lewispg228/Serial_LCD_testbeds/README.md

# Serial_LCD_testbeds
This repo will house testbeds for the new Serial LCDs (both versions: 16x2, 20x4)
