lewispg228/Serial_LCD_testbeds/16x2/TB EAGLE/For lazering/SerLCD_16x2_WT-v01.dxf

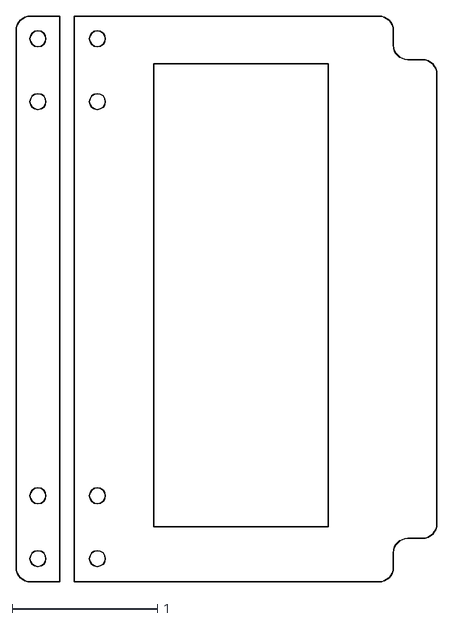
[picture p2: CAD file, 2018-10-10]
16x2/TB EAGLE/For lazering/SerLCD_16x2_WT-v01.dxf
2.90 x 3.90
