lewispg228/Serial_LCD_testbeds/16x2/TB EAGLE/For lazering/SerLCD_16x2_PM-v01.dxf

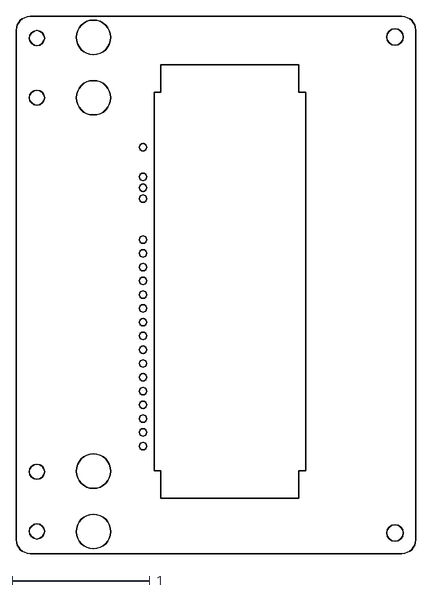
[picture p3: CAD file, 2018-06-07]
16x2/TB EAGLE/For lazering/SerLCD_16x2_PM-v01.dxf
2.90 x 3.90
