lewispg228/Serial_LCD_testbeds/20x4/TB EAGLE/PB/SerLCD_20x4_pb.brd

## EAGLE design 20x4/TB EAGLE/PB/SerLCD_20x4_pb.brd (2020-04-27)

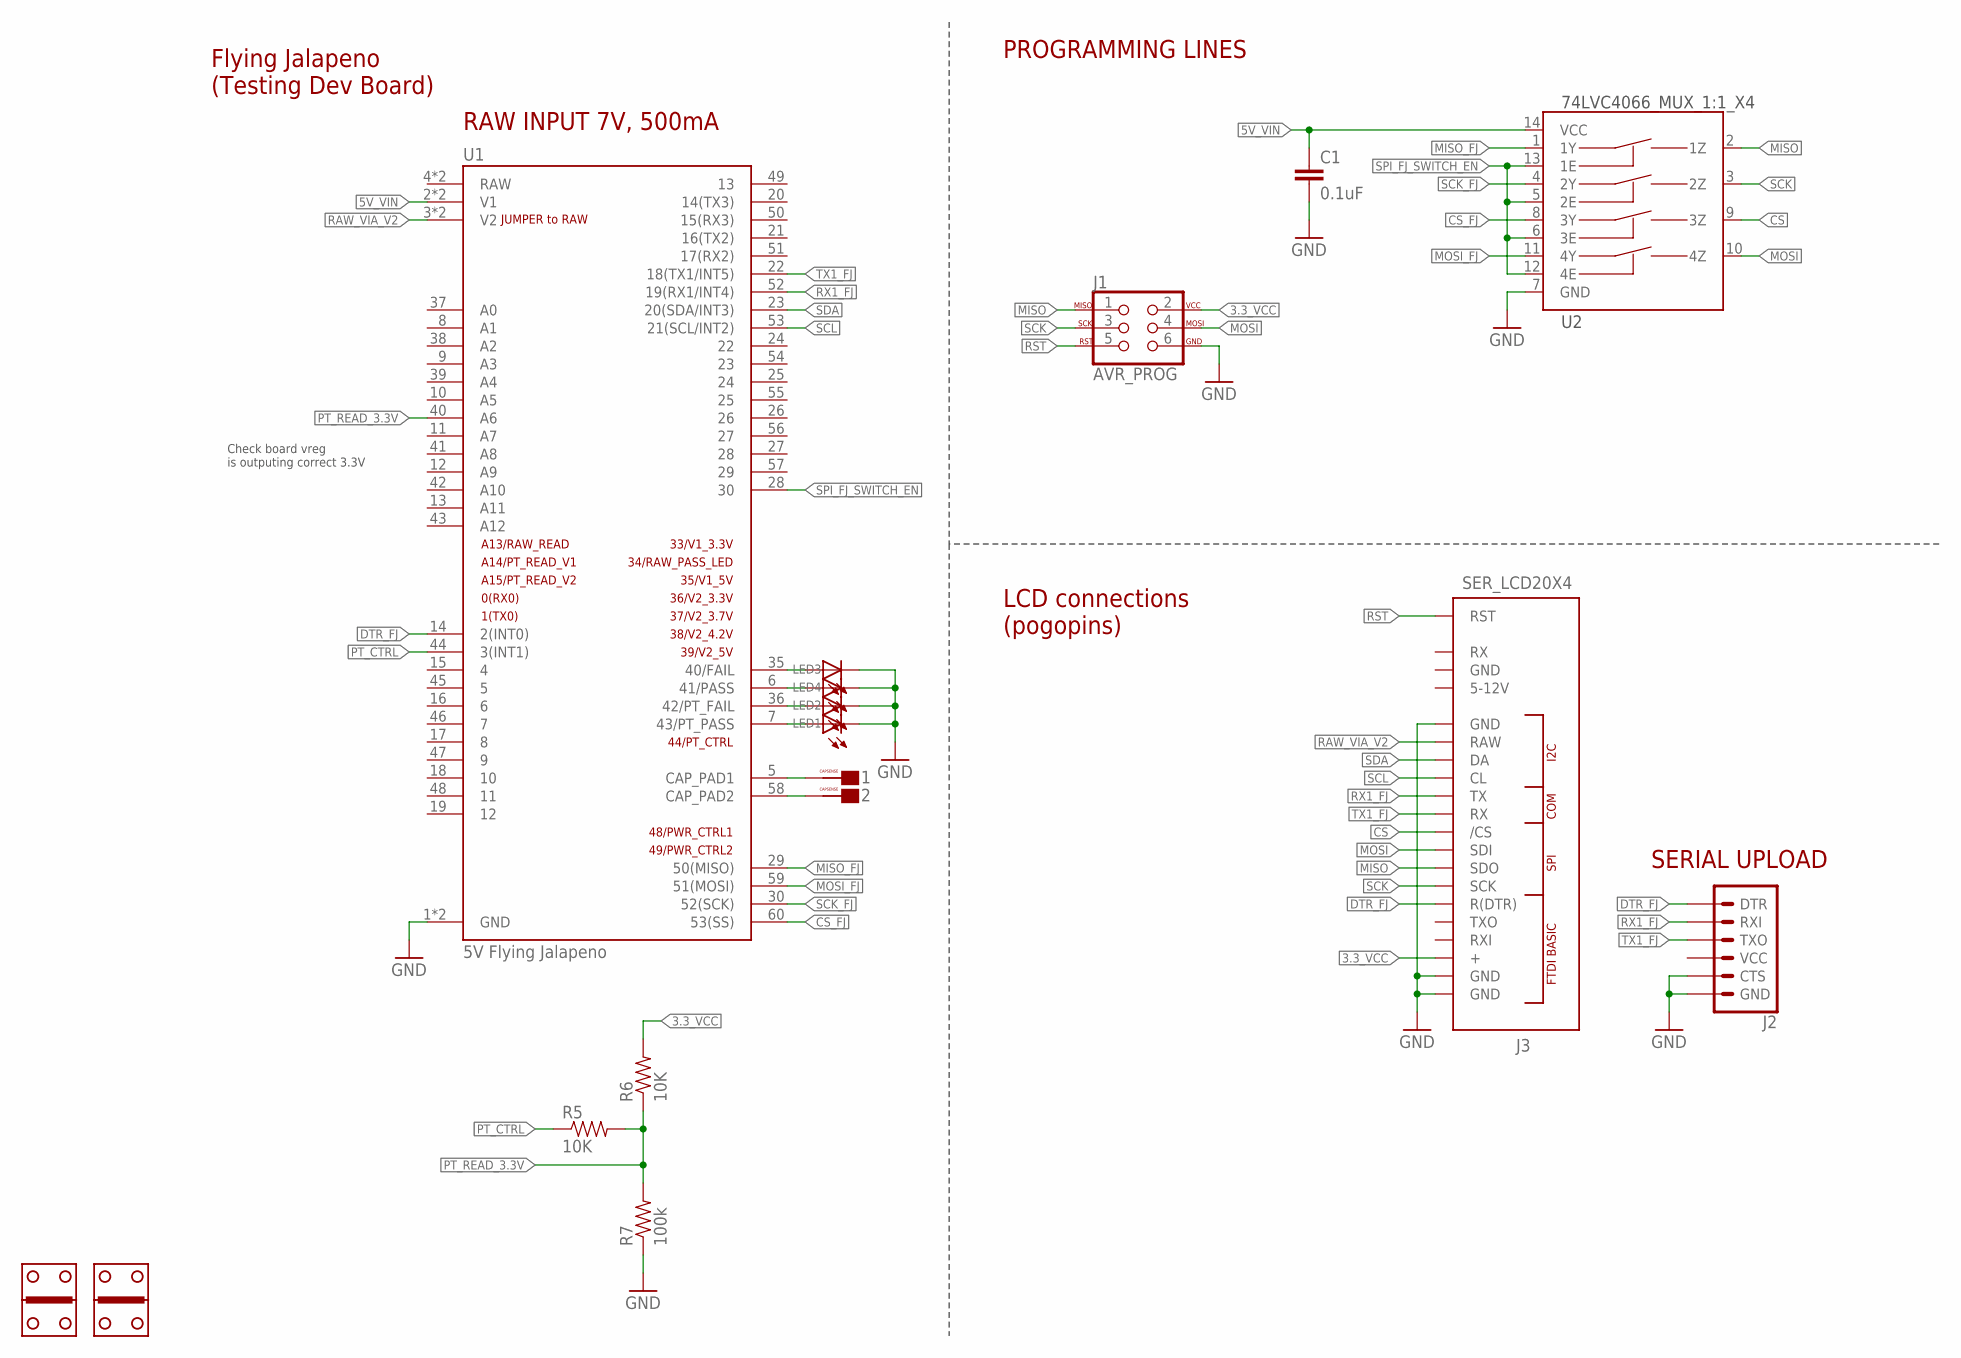
[picture p4: schematic SerLCD_20x4_pb.sch]

Parts:
1, 2: CAPSENSE_BUTTON_PAD_ONLY; CAPSENSE_BUTTON_PADS_ONLY
C1: 0.1uF; 0603-CAP
J1: AVR_PROG; 2X3_LOCK
J2: 6_PIN_SERIAL_TARGETLOCK; 1X06_LOCK
J3: SER_LCD20X4; SER_LCD_20X4
LED1, LED2, LED3, LED4: LED1206; LED-1206
R5, R6: 10K; 0603-RES
R7: 100k; 0603-RES
U1: 5V Flying Jalapeno; FLYING_JALAPENO_V3_1_M
U2: 74LVC4066_MUX_1:1_X4; SO14
U$6, U$7: GOLD_HINDGEPB; GOLD_HINDGE

Connections:
3.3_VCC: J1.2, J3.P$3 (+), R6.2
5V_VIN: C1.1, U1.2 (V1), U1.32 (V1), U2.14 (VCC)
CS: J3.P$10 (/CS), U2.9 (3Z)
CS_FJ: U1.60 (53(SS)), U2.8 (3Y)
DTR_FJ: J2.1 (DTR), J3.P$6 (R(DTR)), U1.14 (2(INT0))
GND: C1.2, J1.6, J2.5 (CTS), J2.6 (GND), J3.P$1 (GND), J3.P$2 (GND), J3.P$16 (GND), LED1.C, LED2.C, LED3.C, LED4.C, R7.1, U1.1 (GND), U1.31 (GND), U2.7 (GND)
MISO: J1.1, J3.P$8 (SDO), U2.2 (1Z)
MISO_FJ: U1.29 (50(MISO)), U2.1 (1Y)
MOSI: J1.4, J3.P$9 (SDI), U2.10 (4Z)
MOSI_FJ: U1.59 (51(MOSI)), U2.11 (4Y)
unnamed: 1.CAPSENSE_PAD, U1.5 (CAP_PAD1)
unnamed: 2.CAPSENSE_PAD, U1.58 (CAP_PAD2)
unnamed: LED1.A, U1.7 (43/PT_PASS)
unnamed: LED2.A, U1.36 (42/PT_FAIL)
unnamed: LED3.A, U1.35 (40/FAIL)
unnamed: LED4.A, U1.6 (41/PASS)
PT_CTRL: R5.1, U1.44 (3(INT1))
PT_READ_3.3V: R5.2, R6.1, R7.2, U1.40 (A6)
RAW_VIA_V2: J3.P$15 (RAW), U1.3 (V2), U1.33 (V2)
RST: J1.5, J3.P$20 (RST)
RX1_FJ: J2.2 (RXI), J3.P$12 (TX), U1.52 (19(RX1/INT4))
SCK: J1.3, J3.P$7 (SCK), U2.3 (2Z)
SCK_FJ: U1.30 (52(SCK)), U2.4 (2Y)
SCL: J3.P$13 (CL), U1.53 (21(SCL/INT2))
SDA: J3.P$14 (DA), U1.23 (20(SDA/INT3))
SPI_FJ_SWITCH_EN: U1.28 (30), U2.5 (2E), U2.6 (3E), U2.12 (4E), U2.13 (1E)
TX1_FJ: J2.3 (TXO), J3.P$11 (RX), U1.22 (18(TX1/INT5))

Notes on the sheet:
Check board vreg is outputing correct 3.3V
JUMPER to RAW
RAW INPUT 7V, 500mA
PROGRAMMING LINES
Flying Jalapeno (Testing Dev Board)
LCD connections (pogopins)
SERIAL UPLOAD

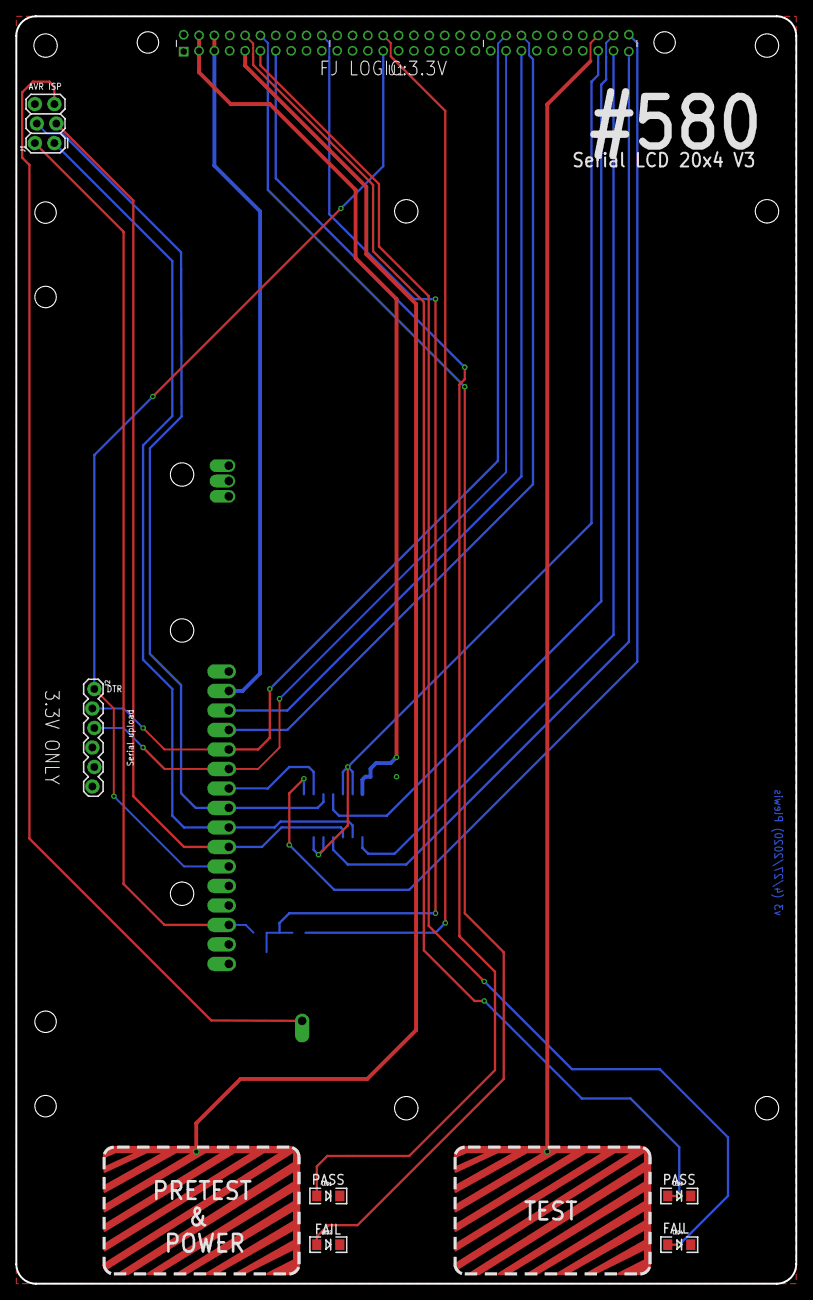
[picture p5: board SerLCD_20x4_pb.brd from above]

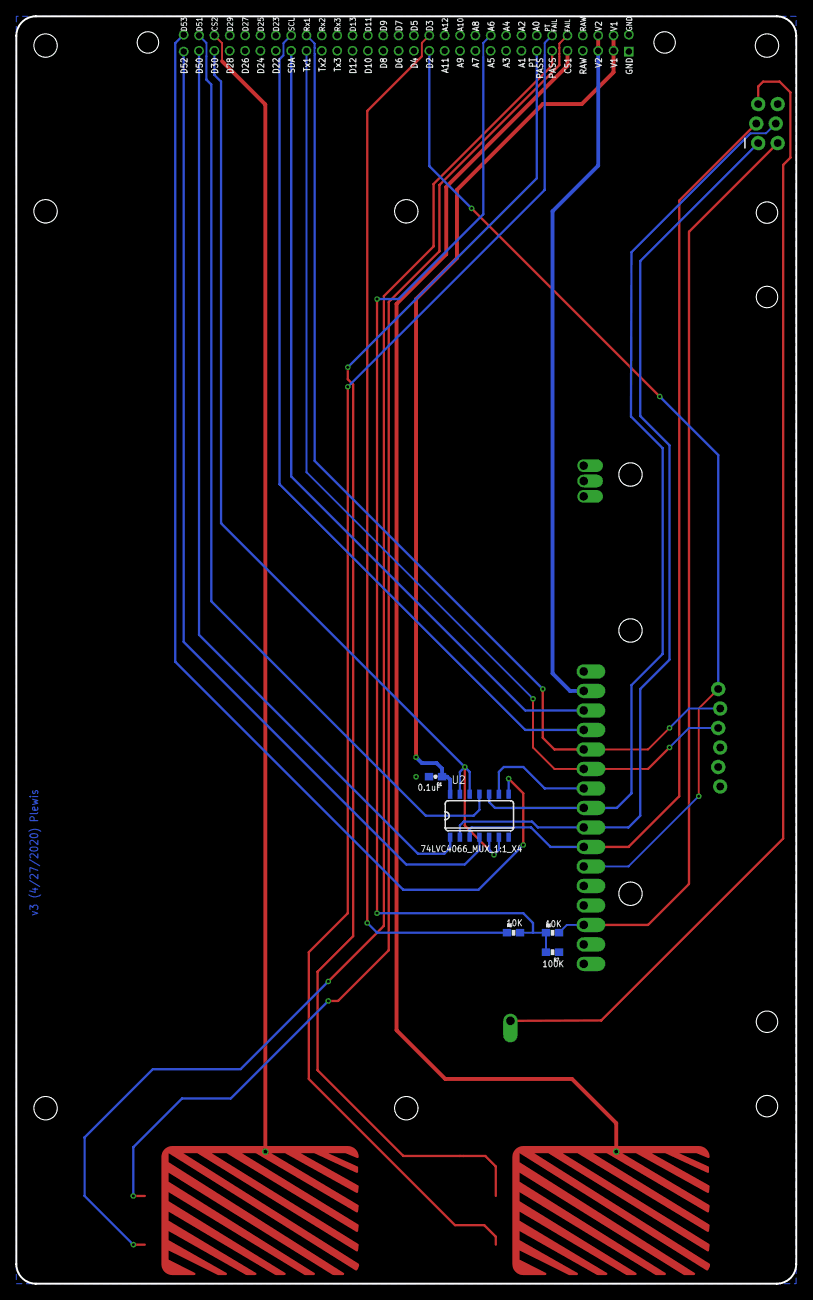
[picture p6: board SerLCD_20x4_pb.brd from below]

Board: 2 copper layers, 101.6 x 165.1 mm, 26 parts (5 on the bottom side), 27 nets.

Other parts of the board:
U$1, U$2, U$3, U$4, U$5, U$8, U$9, U$10, U$11: STAND-OFF-TIGHT
