lewispg228/Serial_LCD_testbeds/16x2/FRITZING_PART/SerLCD_16x2_FRITZTING.brd

## EAGLE design 16x2/FRITZING_PART/SerLCD_16x2_FRITZTING.brd (2018-06-19)

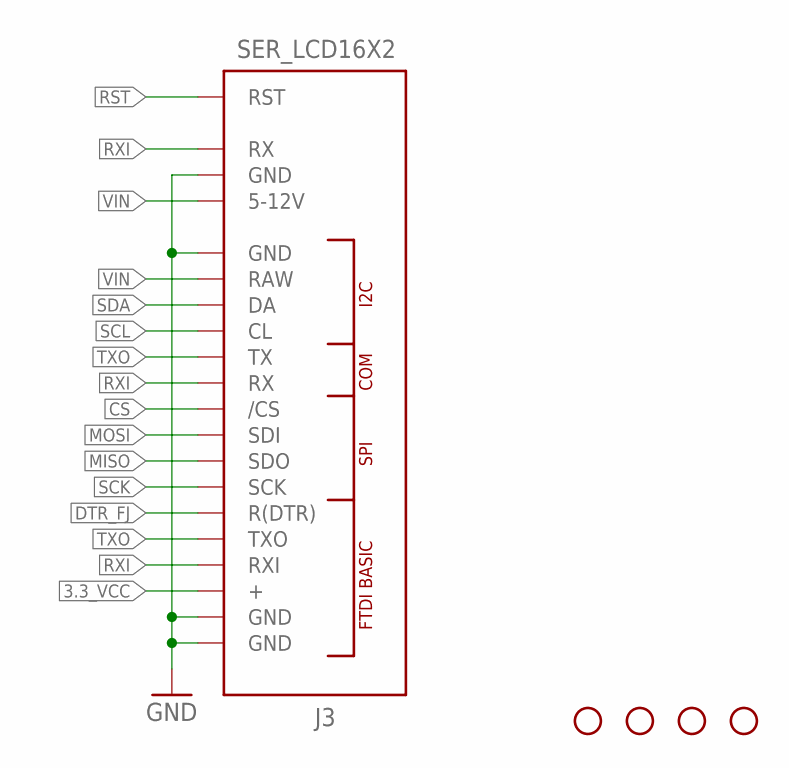
[picture p7: schematic SerLCD_16x2_FRITZTING.sch]

Parts:
H1, H2, H3, H4: STAND-OFF
J3: SER_LCD16X2; SER_LCD_16X2

Connections:
3.3_VCC: J3.P$3 (+)
CS: J3.P$10 (/CS)
DTR_FJ: J3.P$6 (R(DTR))
GND: J3.P$1 (GND), J3.P$2 (GND), J3.P$16 (GND), J3.P$18 (GND)
MISO: J3.P$8 (SDO)
MOSI: J3.P$9 (SDI)
RST: J3.P$20 (RST)
RXI: J3.P$4 (RXI), J3.P$11 (RX), J3.P$19 (RX)
SCK: J3.P$7 (SCK)
SCL: J3.P$13 (CL)
SDA: J3.P$14 (DA)
TXO: J3.P$5 (TXO), J3.P$12 (TX)
VIN: J3.P$15 (RAW), J3.P$17 (5-12V)

Board: 2 copper layers, 5 parts (0 on the bottom side), 4 nets, no tracks yet.
