lewispg228/Serial_LCD_testbeds/16x2/TB EAGLE/PB/SerLCD_16x4_pb-v01.brd

## EAGLE design 16x2/TB EAGLE/PB/SerLCD_16x4_pb-v01.brd (2016-11-15)

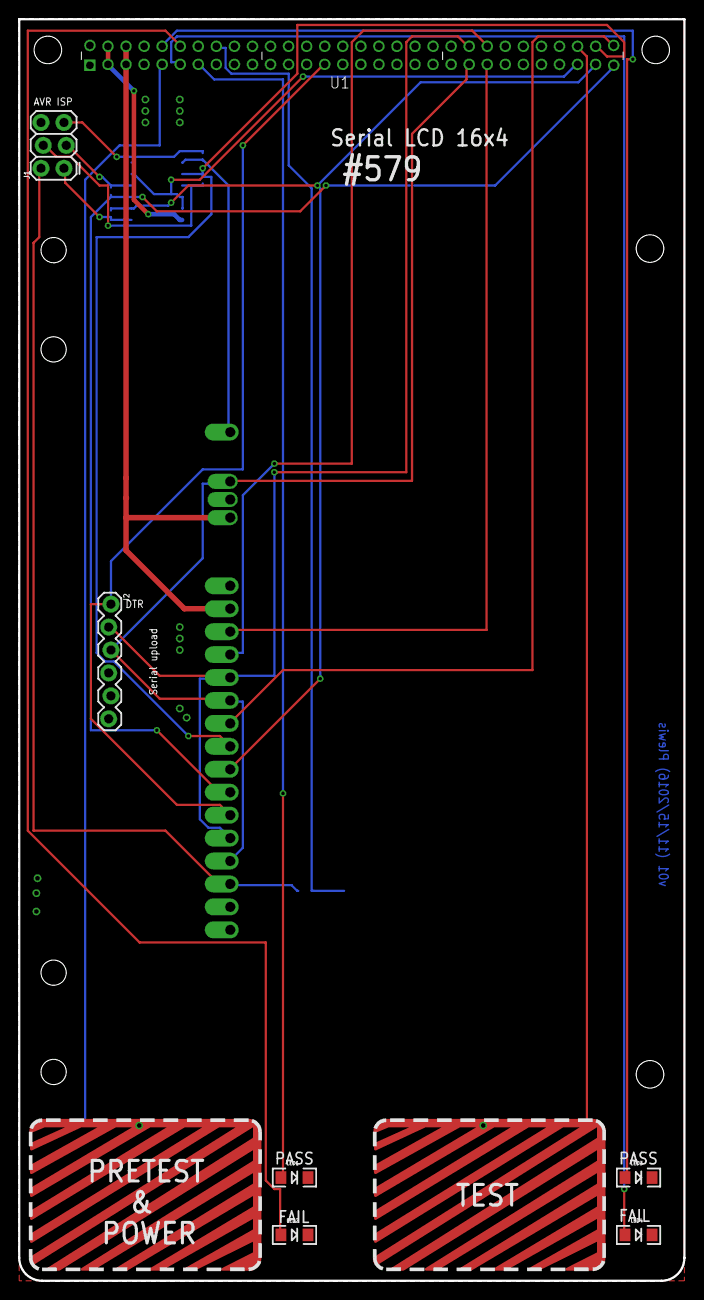
[picture p8: board SerLCD_16x4_pb-v01.brd from above]

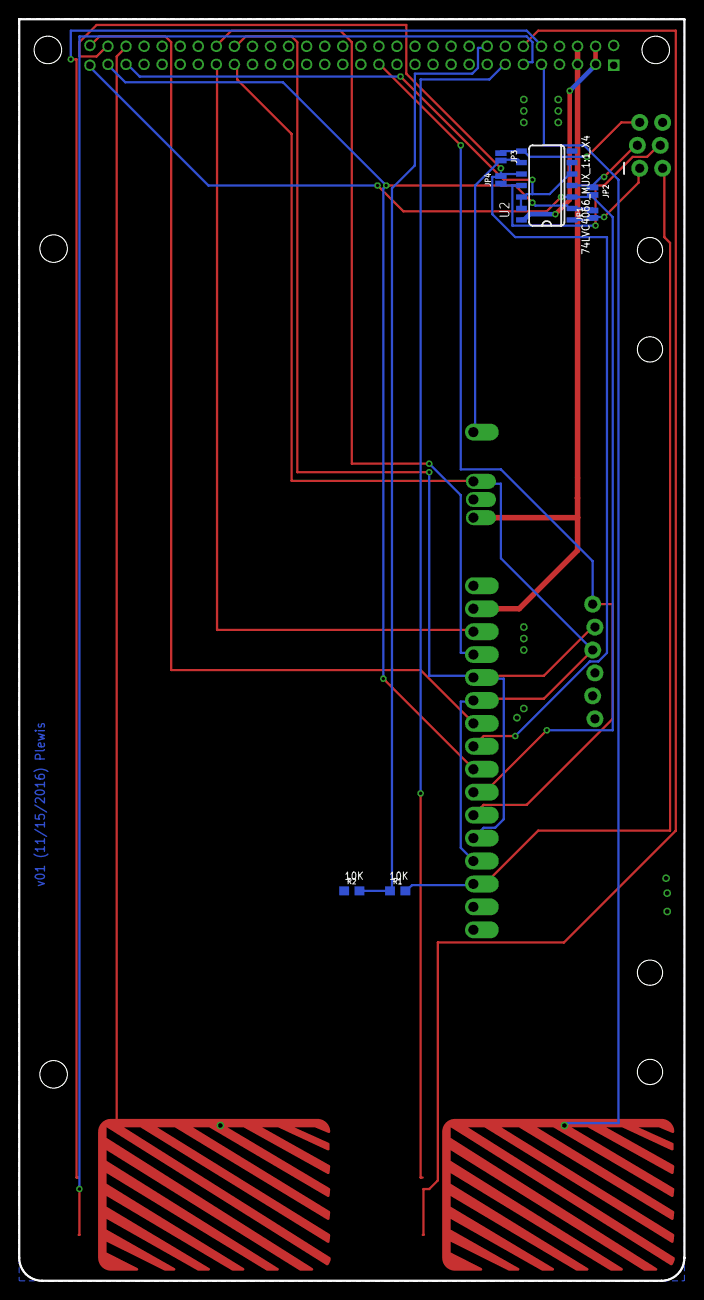
[picture p9: board SerLCD_16x4_pb-v01.brd from below]

Board: 2 copper layers, 73.7 x 139.7 mm, 21 parts (7 on the bottom side), 26 nets.

Parts:
1, 2: CAPSENSE_BUTTON_PAD_ONLY; CAPSENSE_BUTTON_PADS_ONLY
J1: AVR_PROG; 2X3_LOCK
J2: 1X06_LOCK
J3: SER_LCD16X2; SER_LCD_16X2
JP1: MISO; SMT-JUMPER_2_NC_PASTE_NO-SILK
JP2: SCK; SMT-JUMPER_2_NC_PASTE_NO-SILK
JP3: RST; SMT-JUMPER_2_NC_PASTE_NO-SILK
JP4: MOSI; SMT-JUMPER_2_NC_PASTE_NO-SILK
LED1, LED2, LED3, LED4: LED-1206
R1, R2: 10k; 0603
U1: 5V Flying Jalapeno; FLYING_JALAPENO_V2_M
U2: 74LVC4066_MUX_1:1_X4; SO14
U$3, U$8: STAND-OFF-TIGHT
U$6, U$7: GOLD_HINDGEPB; GOLD_HINDGE

Connections:
3.3_VCC: J1.2, J3.P$3, R1.2
5V_VIN: U1.2, U1.32, U2.14
CS: J3.P$10, U1.60
DTR_FJ: J2.1, J3.P$6, U1.14
GND: J1.6, J2.5, J2.6, J3.P$1, J3.P$2, J3.P$16, J3.P$18, LED1.C, LED2.C, LED3.C, LED4.C, R2.1, U1.1, U1.31, U2.7
MISO: J3.P$8, JP1.2, U1.29, U2.2
MISO_P: J1.1, JP1.1, U2.1
MOSI: J3.P$9, JP4.2, U1.59, U2.10
MOSI_P: J1.4, JP4.1, U2.11
unnamed: 1.CAPSENSE_PAD, U1.5
unnamed: 2.CAPSENSE_PAD, U1.58
unnamed: LED1.A, U1.7
unnamed: LED2.A, U1.36
unnamed: LED3.A, U1.35
unnamed: LED4.A, U1.6
unnamed: R1.1, R2.2, U1.38
PGM_SWITCH_EN: U1.28, U2.5, U2.6, U2.12, U2.13
RAW_VIA_V2: J3.P$15, J3.P$17, U1.3, U1.33
RST: J3.P$20, JP3.2, U2.9
RST_P: J1.5, JP3.1, U2.8
RX1_FJ: J2.2, J3.P$5, J3.P$12, U1.52
SCK: J3.P$7, JP2.2, U1.30, U2.3
SCK_P: J1.3, JP2.1, U2.4
SCL: J3.P$13, U1.53
SDA: J3.P$14, U1.23
TX1_FJ: J2.3, J3.P$4, J3.P$11, J3.P$19, U1.22
