lewispg228/Serial_LCD_testbeds/(commit log)

2016-11-15 prelim layout and temp library for dimensions
    [SerLCD_16x4_pb-v01.brd, SerLCD_16x4_pb-v01.sch]
2016-11-15 finished up devices in temp library
2016-11-15 Some library work, and the 16x4 is almost done
    [SerLCD_16x4_pb-v01.brd, SerLCD_16x4_pb-v01.sch]
2016-11-15 labels on prgramming headers
    [SerLCD_16x4_pb-v01.brd]
2016-11-15 finished up 16x4 (PB/PM/PF/WT)
    [SerLCD_16x4_PF-v01.brd, SerLCD_16x4_PF-v01.sch, SerLCD_16x4_PM-v01.brd, SerLCD_16x4_PM-v01.sch, SerLCD_16x4_WT-v01.brd, SerLCD_16x4_WT-v01.sch, SerLCD_16x4_pb-v01.brd]
2016-11-15 finshed up 20x4, RFR
    [SerLCD_16x2_PF-v01.brd, SerLCD_16x2_PF-v01.sch, SerLCD_16x2_PM-v01.brd, SerLCD_16x2_PM-v01.sch, SerLCD_16x2_WT-v01.brd, SerLCD_16x2_WT-v01.sch, SerLCD_16x2_pb-v01.brd, SerLCD_16x2_pb-v01.sch]
2016-12-06 added preTest to 3.3V on 16x2
    This will also be used to verify that the vreg is outputing proper
    voltage later in the test.
    NOTE: I still need to add this to 20x4 version
    [SerLCD_16x2_pb-v01.brd, SerLCD_16x2_pb-v01.sch]
2016-12-06 added preTest to 3.3V output on 20x4
    ready to order both designs... gonna throw on a QC panel asap
    [SerLCD_20x4_pb-v01.brd, SerLCD_20x4_pb-v01.sch]
2016-12-06 added rout out area to PM
    [SerLCD_16x2_PM-v01.brd, SerLCD_16x2_PM-v01.sch]
2016-12-06 added "route out" text to PF
    [SerLCD_16x2_PF-v01.brd, SerLCD_16x2_PF-v01.sch]
2017-02-20 Arduino compatible bootloader for 11.0592MHz
    pulled this in from bug attachment from nate on 1/11/2917
2017-02-21 preliminary testbed code for 20x4
    pretests working. powers up, sets contrast to 50, sends full screen of
    numbers over serial.
    Still need to incorporate all other comm lines to product, and
    backlight.
2017-02-21 moved serial test into function added i2c_ping
    also moved "test_vcc()" into "test()"
2017-02-21 serial, spi, i2c working
    still need backlight, and "all characters full" test.
    Also, might be able to somehow use same code on both testbeds, but not
    sure if this is possible.
2017-02-22 created monochrome and RGB backlight test
    This will be less confusing for the techs. I will call the appropriate
    function for the type of screen...
    not sure what to do about the 16x4 though.: both the RGB and monochrome
    version of that share a testbed, so they will probably have some
    confusing messages pop up if the screen is monochrome, but I still send
    commands for RGB.
    Also, I'm noticing that the brightness settings are backwards. The auto
    message text is aligned with the commands, however the actual brightness
    of the backlight is reversed.
    [SerLCD_testbed_v01.ino]
2017-02-22 fixed power down issue
    It seems that the CS_PIN is "slightly" jumpered to my high side switch
    control lines (I'm thinking this is a fault in the FJ itself or the
    daughter board).
    I'm measuring 40 ohms between CS_PIN and 49/48.
    [SerLCD_testbed_v01.ino]
2017-03-27 Moving VCC test to 3.3V
    3.3V because that's the logic level of the latest proto I'm working
    with. All future 20x4 lcd screens should have a logic of 3.3V
    Note the board in hand right now has a sticker with a date on it that
    says "2016-9-25"
2017-04-03 still deving for the 20x4
    VCC test actually is reading more like 1.7V
    movign to the RGB backlight test - to see all three colors
    removed contrast test - found that 10 works well.
    slowed down delays a bit to see whats going on
2017-05-15 programming lines switch IC vcc to 3.3V
    Also, some rx tx testing on prototypes.
2017-05-15 Adding in VCC to correct verifyVoltage() when using 3.3V logic FJ
    Note, also had to update FlyingJalapeno library repo
    [SerLCD_testbed_v01.ino]
2017-05-16 updating FJ setup comment to be accurate
    All of the LCDs operate at 3.3V, so we match that with the FJ on it's
    own VCC and the V1 that supplies logic level for the programming lines
    switch.
2017-05-19 protective bases
    designed by measuring from actual built up testbeds. worked out pretty good, but would have been much faster to convert from eagle.
    Note, there is a file that contains both 16x2 and 20x4, for easier laser cutting.
2018-06-07 Prepped 16x4_PM for acrylic - drills to 55mils
    also moved "route out" text to tplace
    also created dxf file for lazering
    [SerLCD_16x2_PM-v01.brd, SerLCD_16x2_PM-v01.dxf]
2018-06-18 speeding up test for amotech production
    decreased a lot of delays, also added in some delays (just 200ms) to break up the sections of the test. Without these little delays, it seemed to be missing the I2C and SPI commands.
    [SerLCD_testbed_v01.ino]
2018-06-19 created a simple board file for fritzing part creation hope it works
    [SerLCD_16x2_FRITZTING.brd, SerLCD_16x2_FRITZTING.sch]
2018-10-10 exported to dxf for lazering acrylic layers
    [SerLCD_16x2_PF-v01.dxf, SerLCD_16x2_PM-v01.dxf, SerLCD_16x2_WT-v01.dxf]
2019-02-18 updating switch circuit and re-routing
    the pi_grammer has the isolation switch, so I am now using the onboard switch to isolate the FJ's SPI lines. This will hopefully elliminate the need for the occasional hard reset on the testbed.
    Re-routing everything manually. The original design was autorouted and was pretty ugly.
    Currently most of the important stuff is routed nicely. Still needs LEDs and some switch stuff routed.
    [SerLCD_16x2_pb-v01.brd, SerLCD_16x2_pb-v01.sch]
2019-02-19 finished re-routing on PB
    [SerLCD_16x2_pb-v01.brd]
2019-02-21 renaming without version number in name
    [SerLCD_16x2_pb.brd, SerLCD_16x2_pb.sch, SerLCD_20x4_pb.brd, SerLCD_20x4_pb.sch]
2019-02-21 20x4 pb routing done
    -changed switch to isolate FJ SPI lines (because the new pi_grammer has isolation built in)
    -added more support beam standoffs
    -moved to new FJ footprint for easier assembly on RA 2x30 header.
    [SerLCD_20x4_pb.brd, SerLCD_20x4_pb.sch]
2020-04-27 16x2 testbed PB updated for new qwiic connector version
    [SerLCD_16x2_pb.brd, SerLCD_16x2_pb.sch]
2020-04-27 20x4 testbed PB updated for new qwiic connector version
    -also removed old PM footprints, cuz these aren't used in making acrylic layers anyways, and they are now out of date with pogopin spacing.
    [SerLCD_20x4_pb.brd, SerLCD_20x4_pb.sch]
